enriquewph/PowerMike/docs/first-test-images/first-test (5).jpg

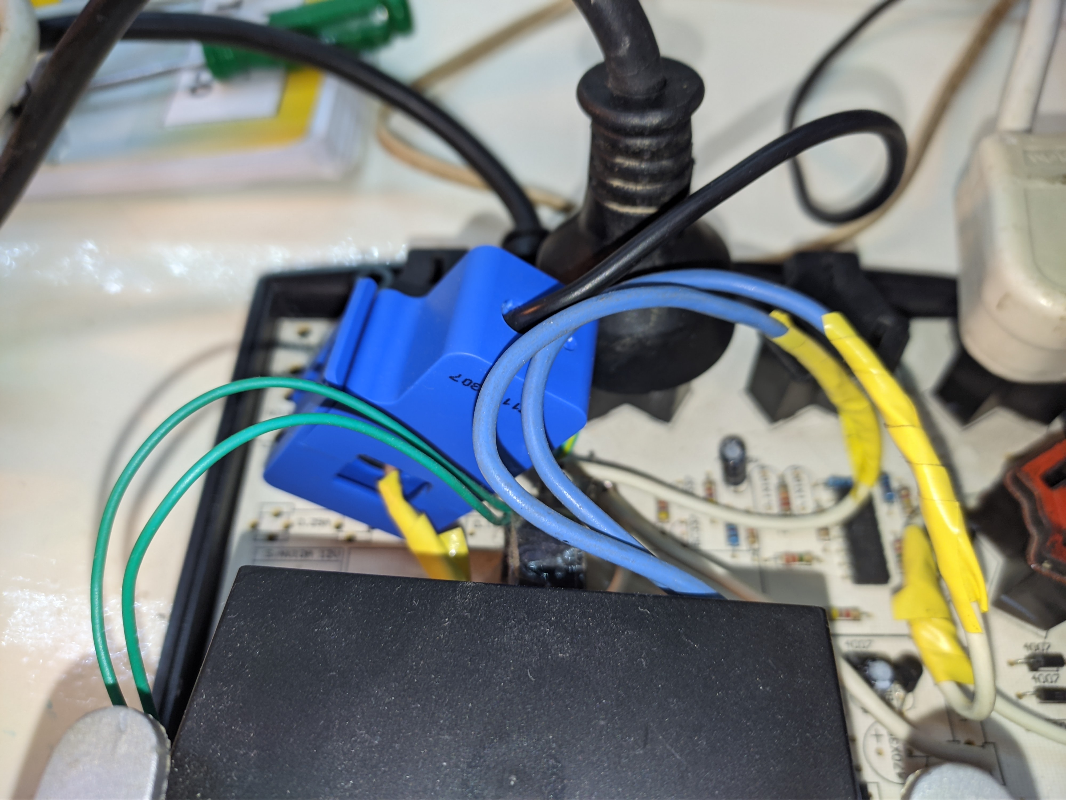
docs/first-test-images/first-test (5).jpg
