enriquewph/PowerMike/docs/first-test-images/first-test (2).jpg

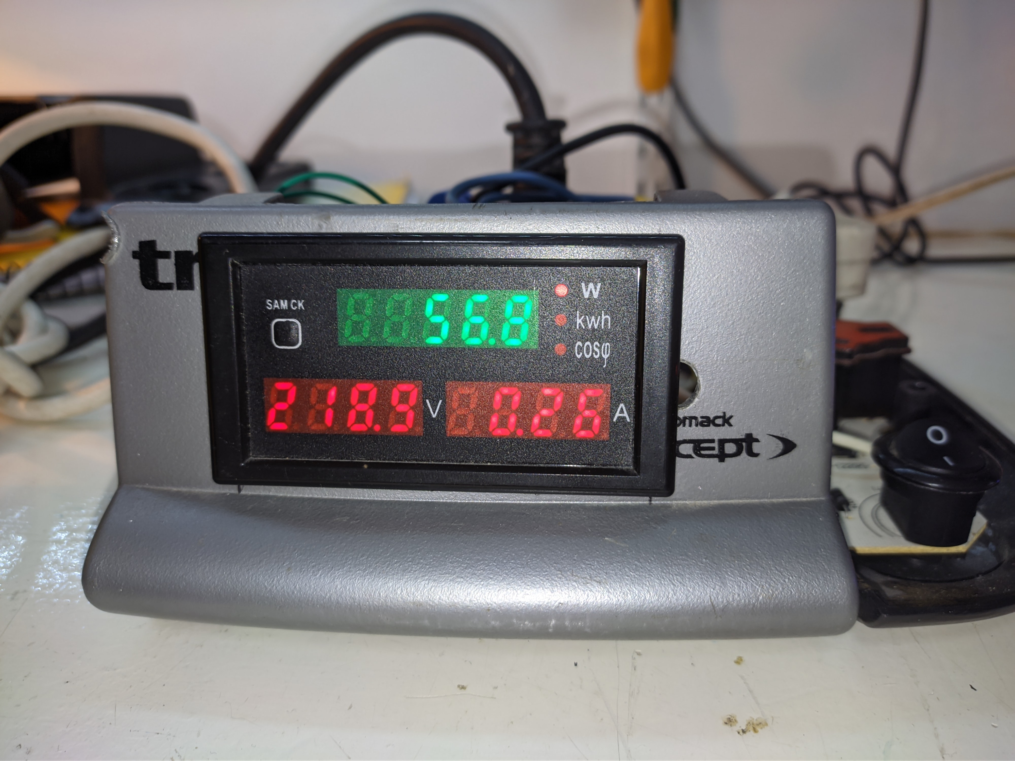
docs/first-test-images/first-test (2).jpg
