enriquewph/PowerMike/README.md

# PowerMike
Equipo para medir el consumo eléctrico de una vivienda.
