enriquewph/PowerMike/docs/qrlink.png

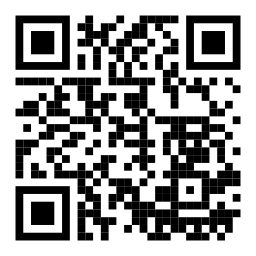
docs/qrlink.png
