enriquewph/PowerMike/hardware/export/conexionado.png

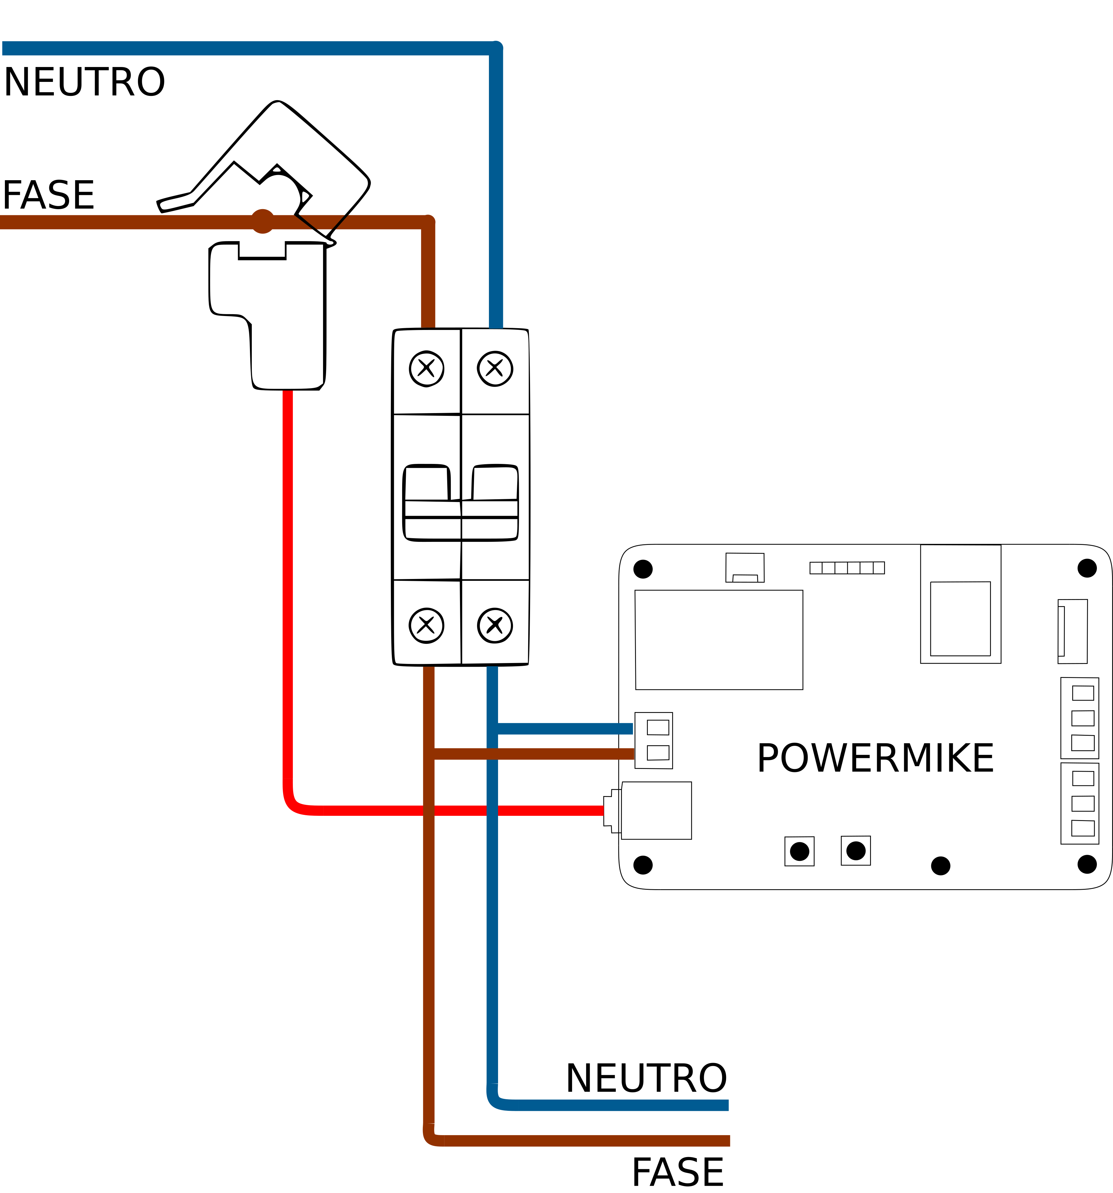
hardware/export/conexionado.png
