enriquewph/PowerMike/hardware/export/dwg.png

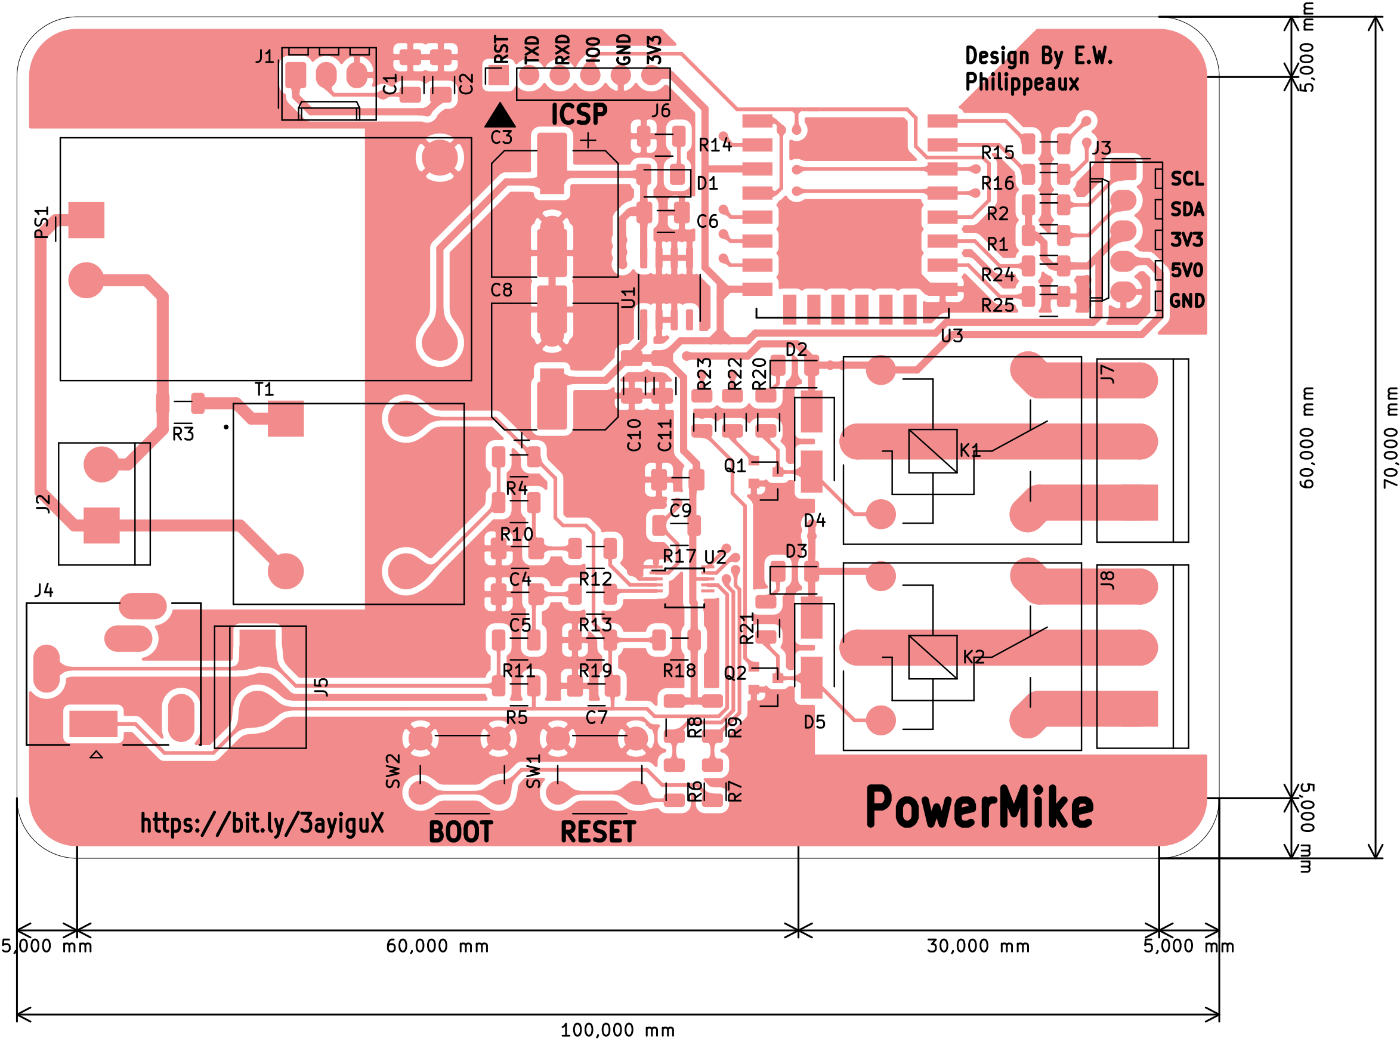
hardware/export/dwg.png
