enriquewph/PowerMike/hardware/export/pcb-solo-back.png

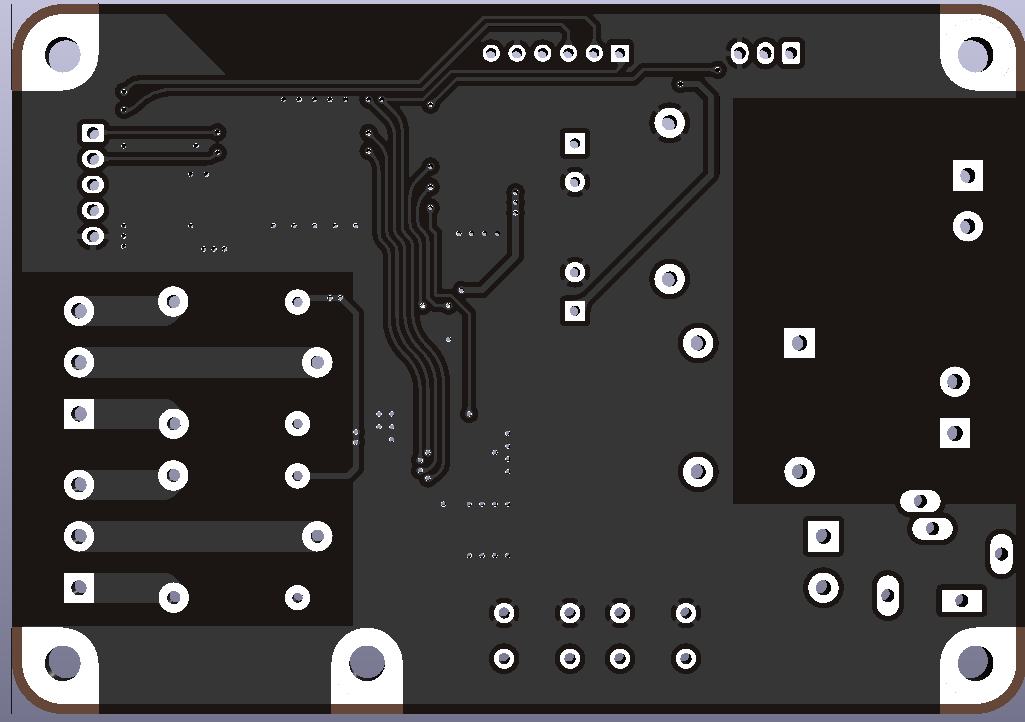
hardware/export/pcb-solo-back.png
