enriquewph/PowerMike/hardware/export/pcb-solo.png

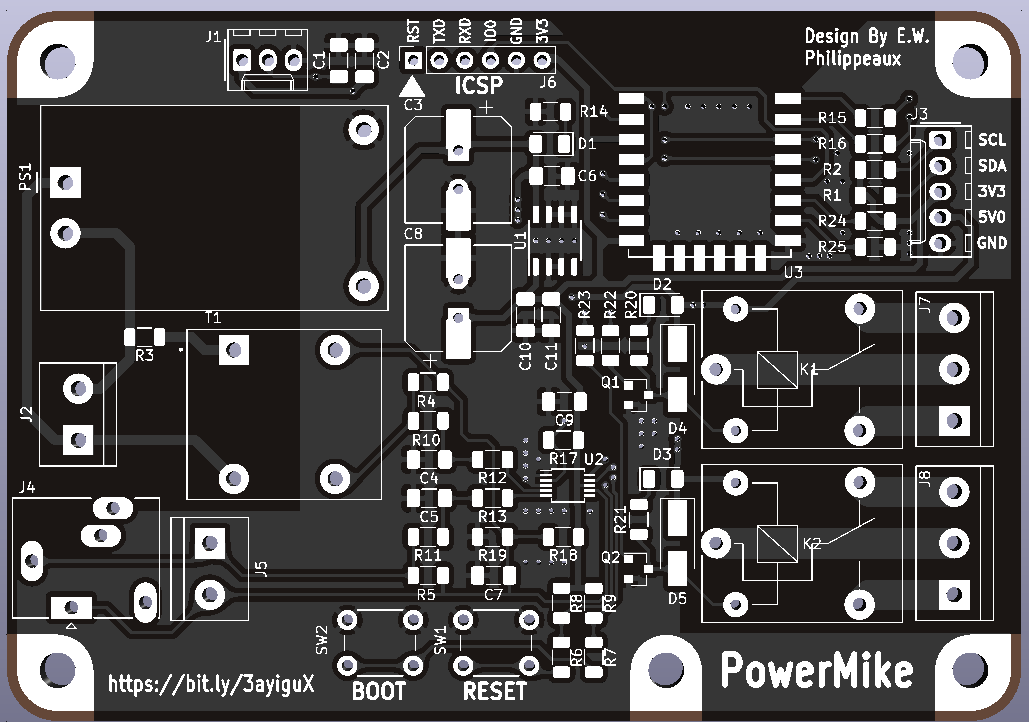
hardware/export/pcb-solo.png
