enriquewph/PowerMike/hardware/export/sch-descompuesto/alimentacion-sensores-adc.png

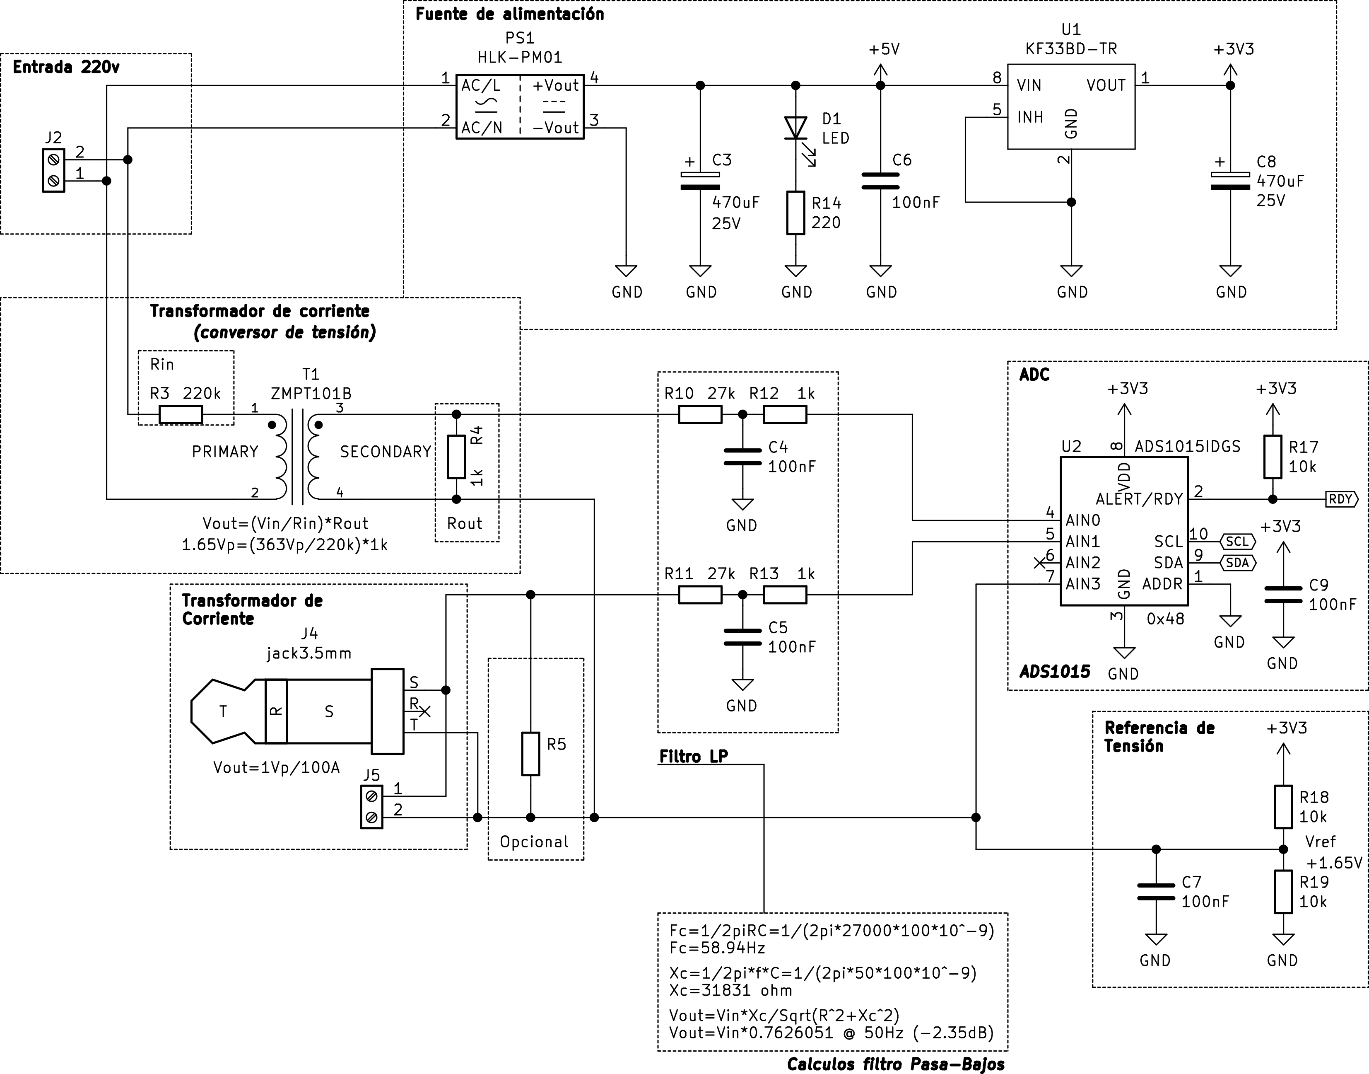
hardware/export/sch-descompuesto/alimentacion-sensores-adc.png
