enriquewph/PowerMike/hardware/export/sch-descompuesto/botones.png

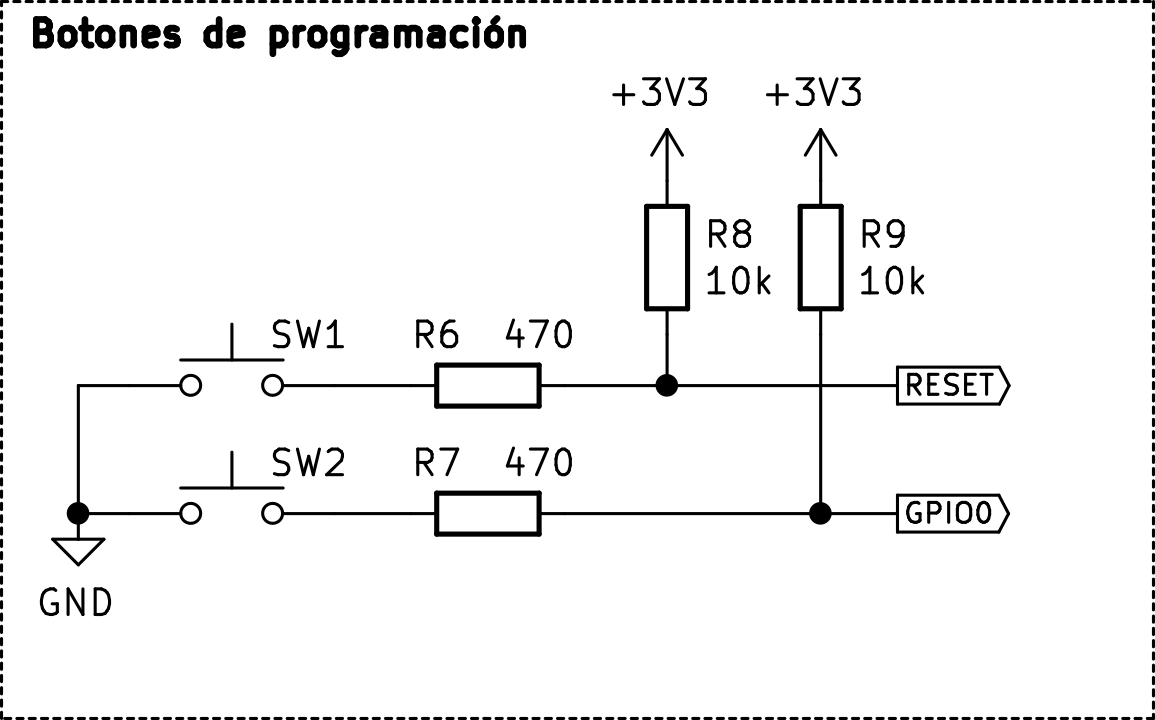
hardware/export/sch-descompuesto/botones.png
