enriquewph/PowerMike/hardware/export/sch-descompuesto/conectores.png

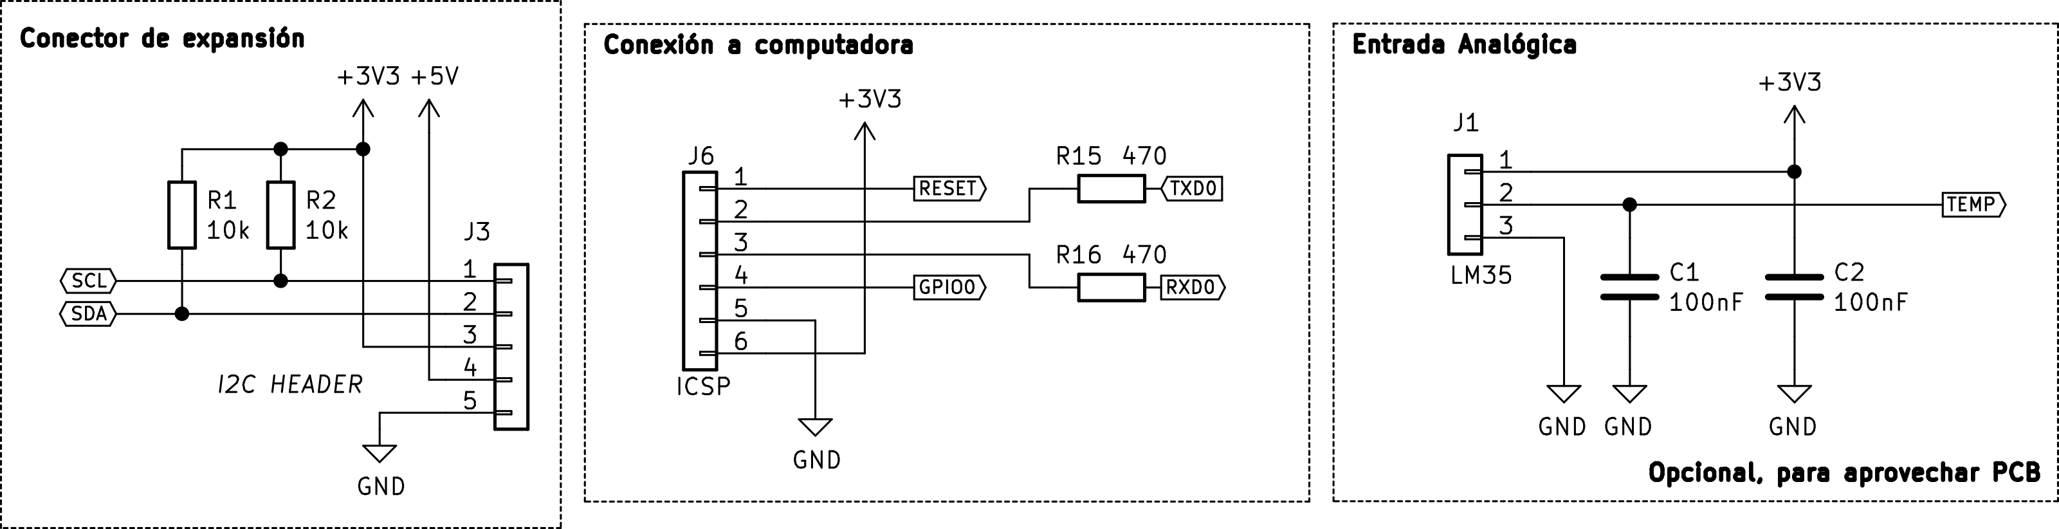
hardware/export/sch-descompuesto/conectores.png
