enriquewph/PowerMike/hardware/export/sch-descompuesto/microcontrolador.png

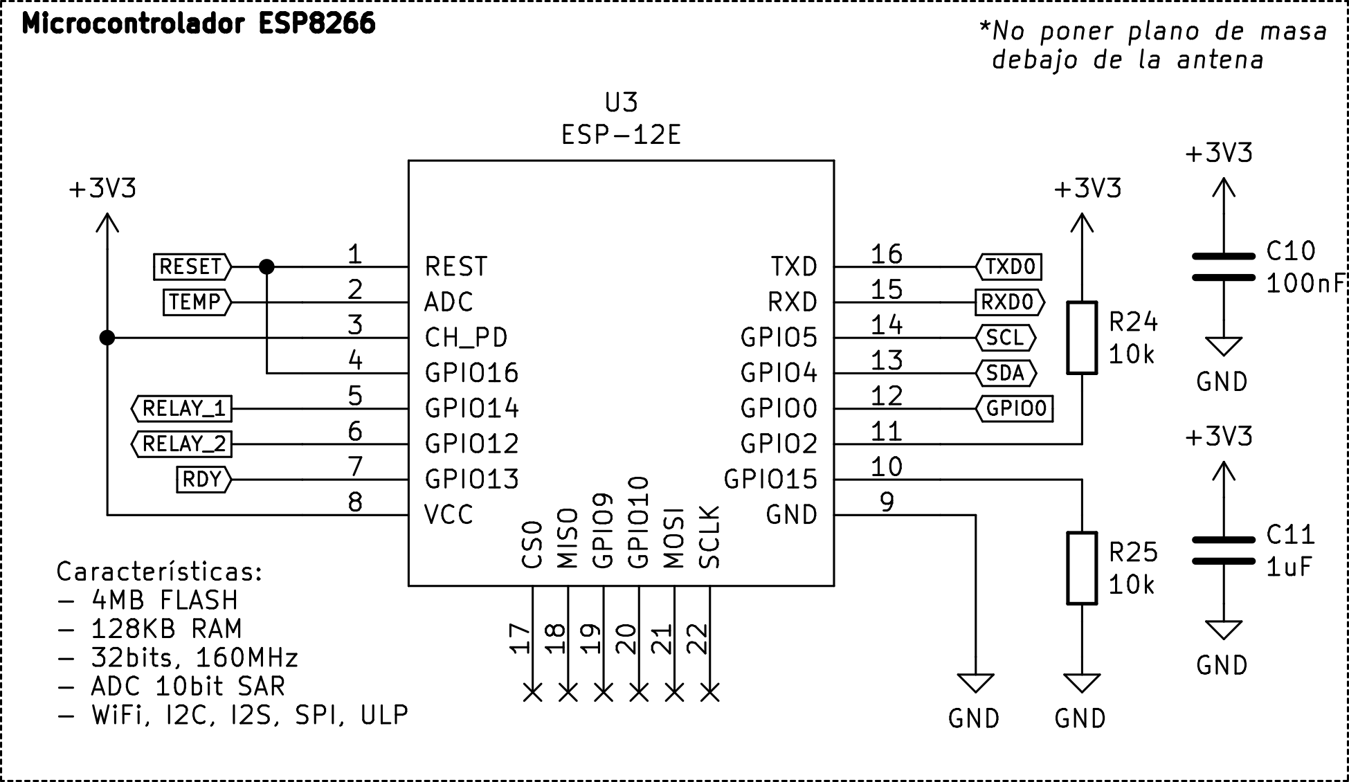
hardware/export/sch-descompuesto/microcontrolador.png
