enriquewph/PowerMike/hardware/export/sch-descompuesto/relays.png

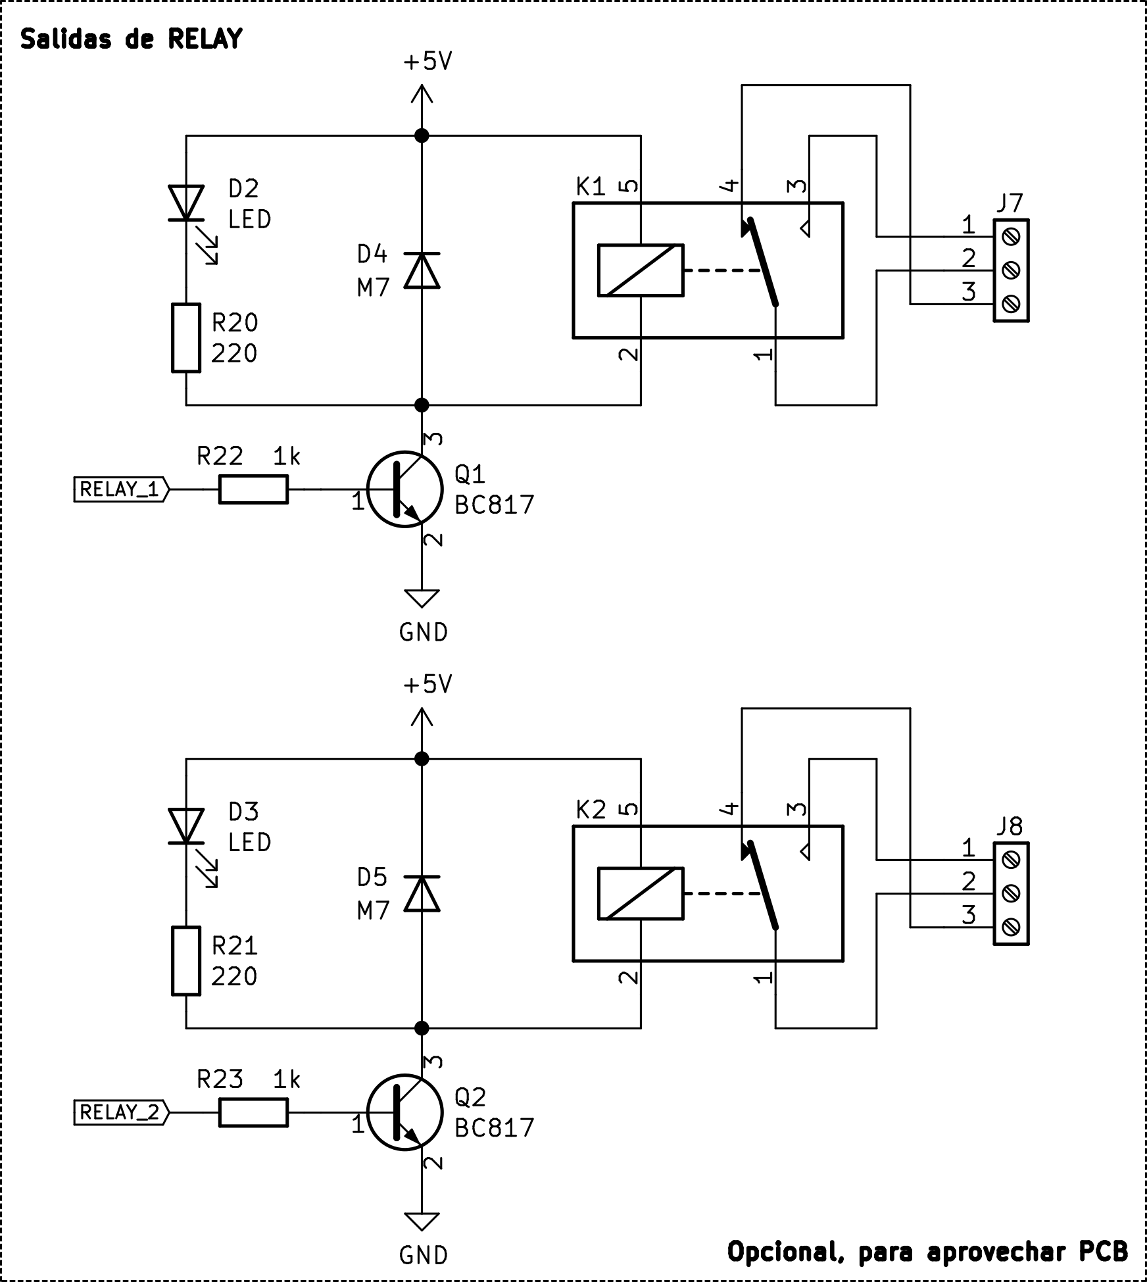
hardware/export/sch-descompuesto/relays.png
