enriquewph/PowerMike/hardware/export/sch.png

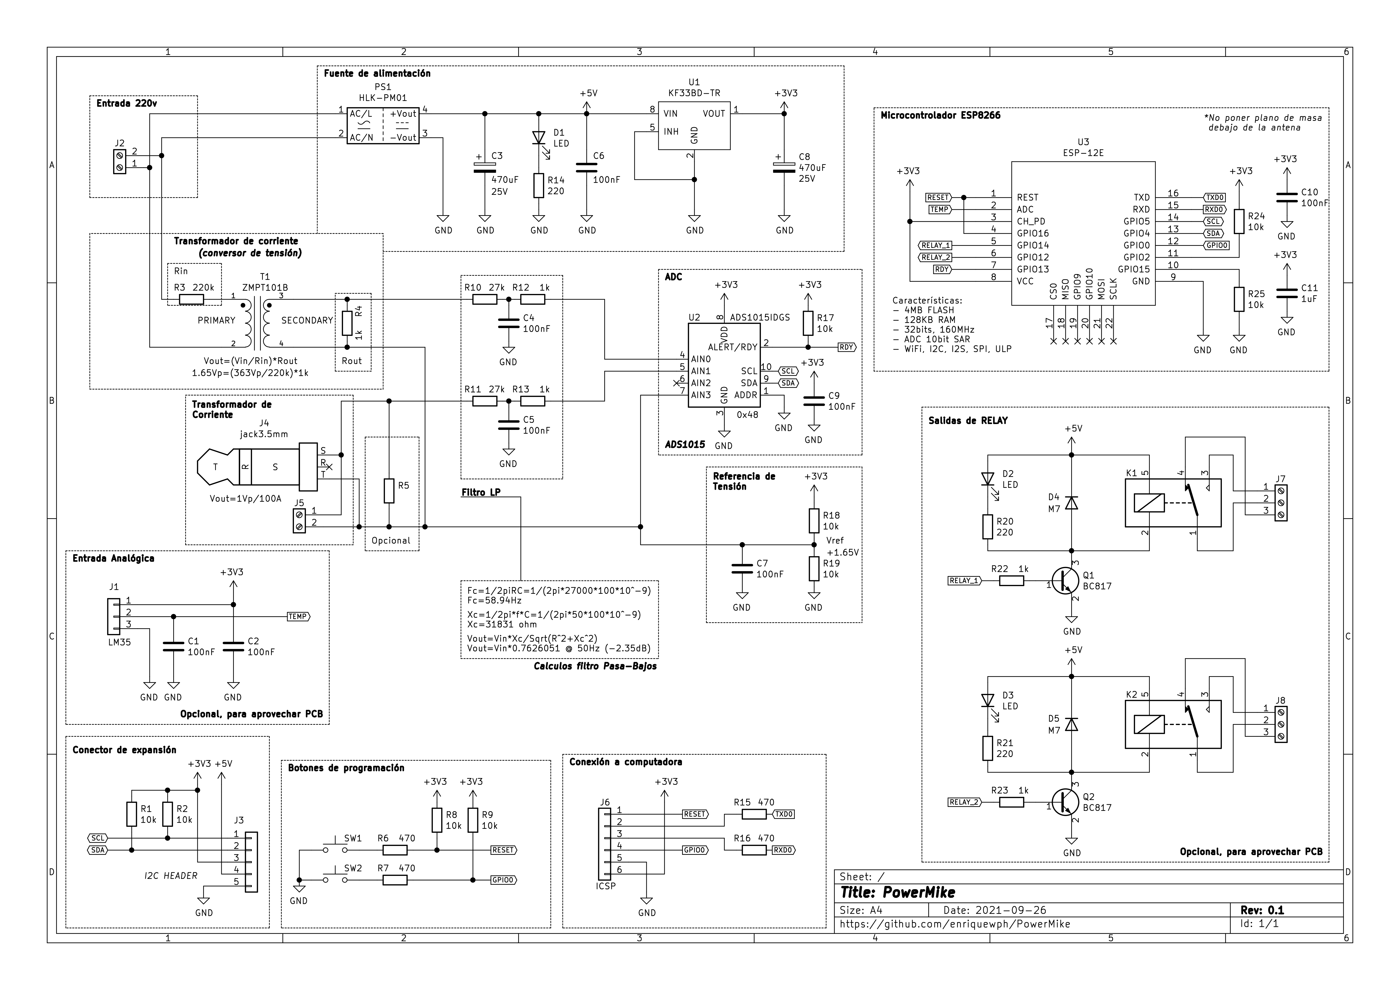
hardware/export/sch.png
