enriquewph/PowerMike/hardware/export/pcb-componentes.png

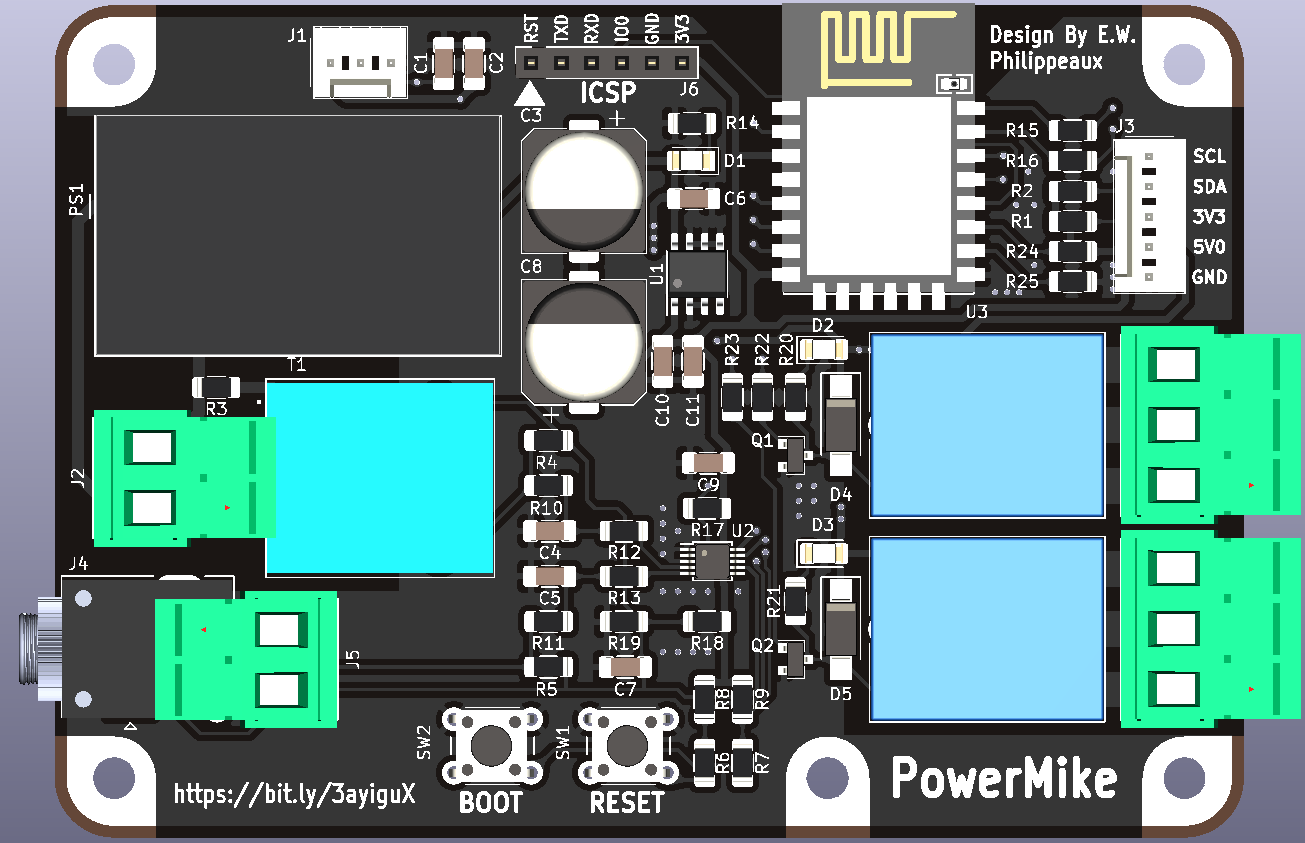
hardware/export/pcb-componentes.png
