enriquewph/PowerMike/hardware/3dcad/Ensamblaje1.SLDASM

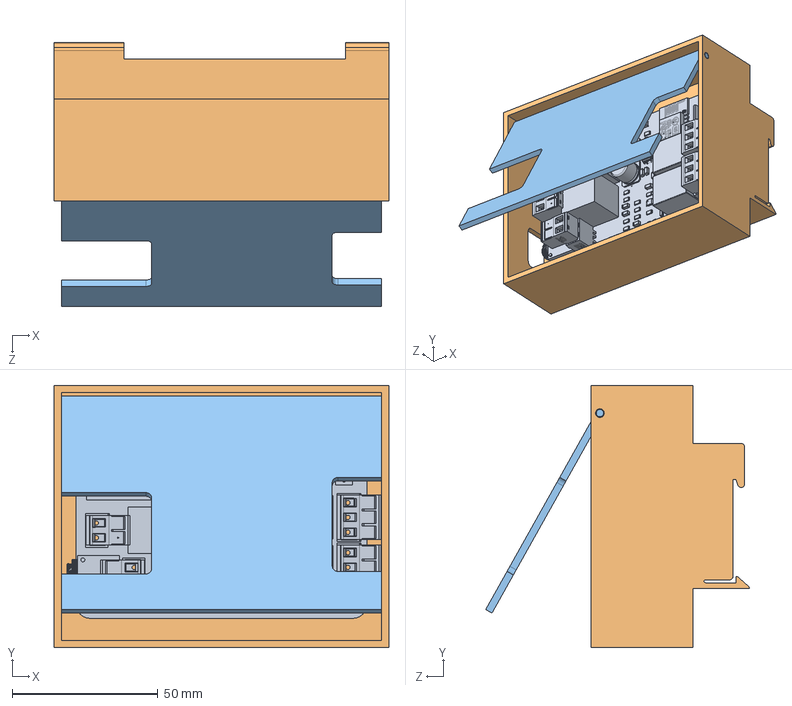
[picture p15: CAD file, 2022-03-10]
hardware/3dcad/Ensamblaje1.SLDASM
115.0 x 90.0 x 90.5 mm
powermike
caja
tapa
