enriquewph/PowerMike/hardware/3dcad/tapa.SLDPRT

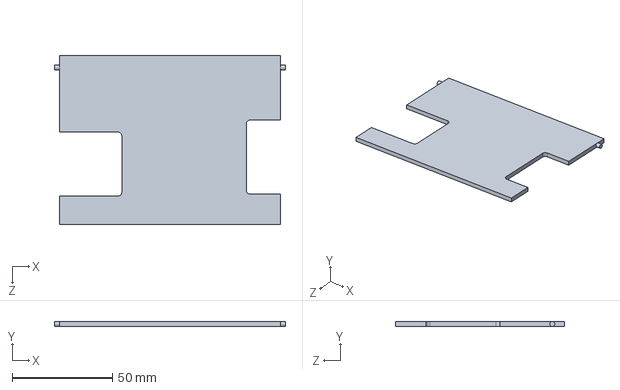
[picture p16: CAD file, 2022-03-10]
hardware/3dcad/tapa.SLDPRT
115.0 x 2.50 x 84.0 mm
