enriquewph/PowerMike/hardware/3dcad/caja.SLDPRT

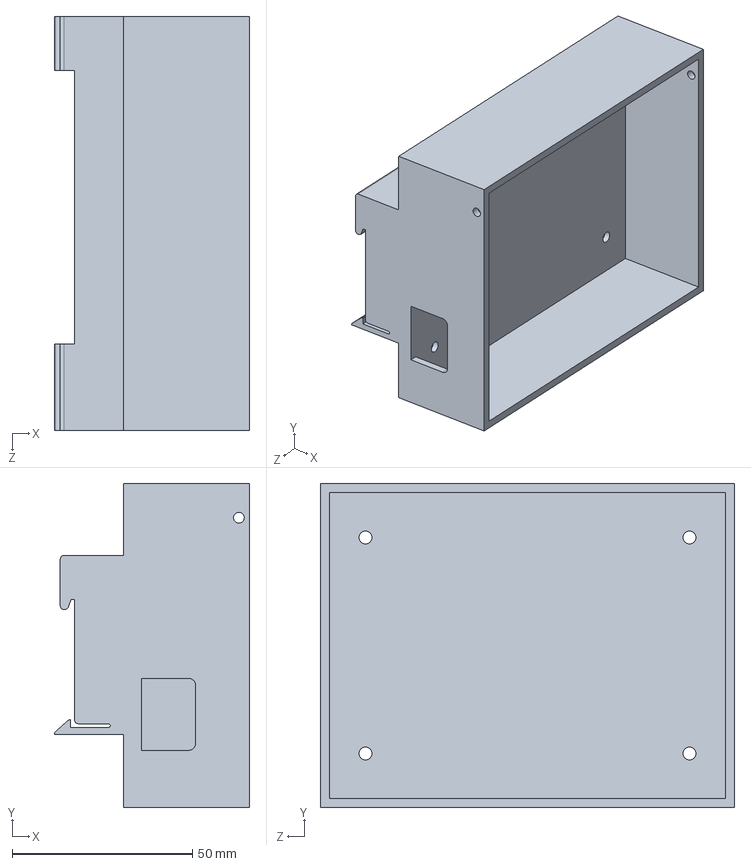
[picture p17: CAD file, 2022-03-10]
hardware/3dcad/caja.SLDPRT
54.3 x 90.0 x 115.0 mm
