enriquewph/PowerMike/docs/first-test-images/first-test (1).jpg

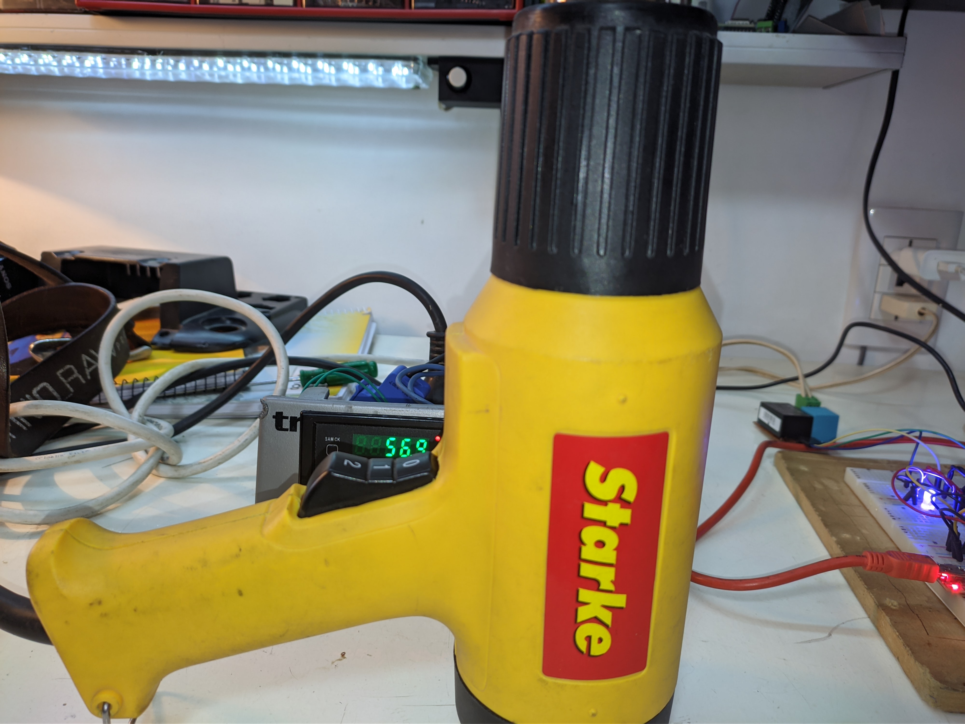
docs/first-test-images/first-test (1).jpg
