enriquewph/PowerMike/docs/first-test-images/first-test (3).jpg

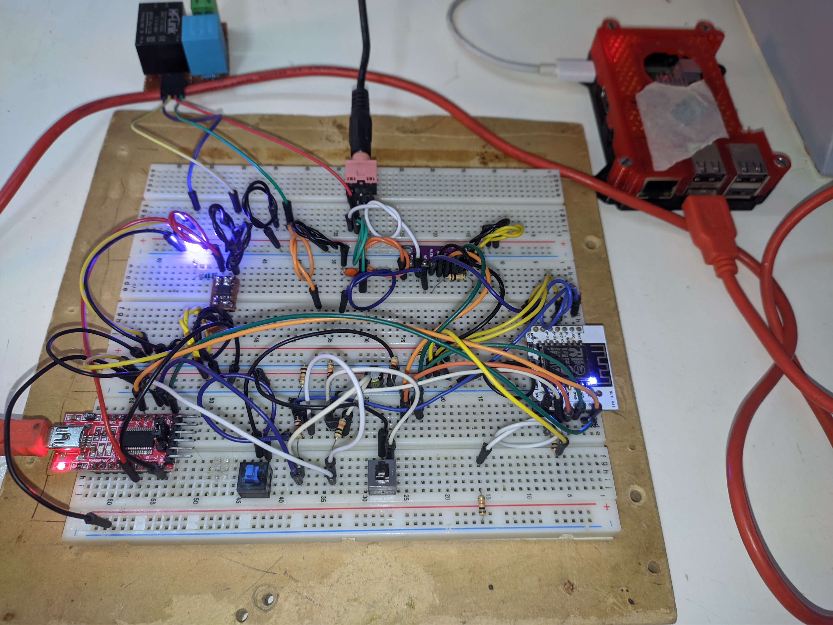
docs/first-test-images/first-test (3).jpg
