enriquewph/PowerMike/docs/first-test-images/first-test (4).jpg

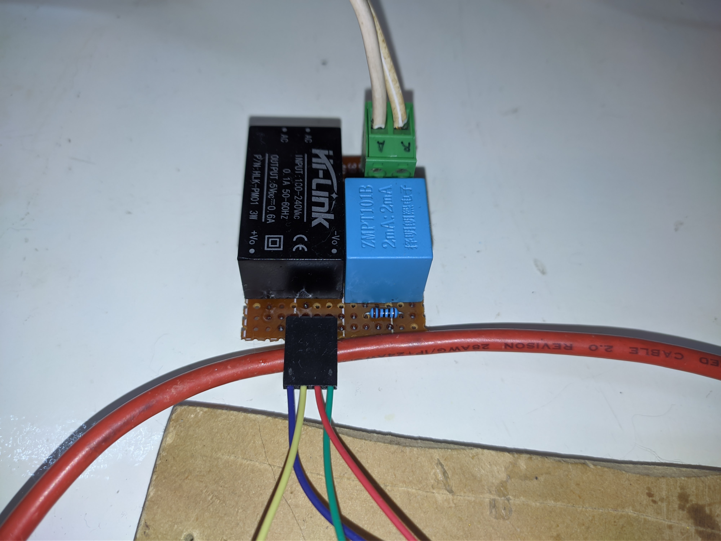
docs/first-test-images/first-test (4).jpg
