enriquewph/PowerMike/(threads)

Thread 1 (2021-09-22):

investigar como leer el sensor de corriente.

enriquewph, 2021-09-22:
usar ads1115 + sct-013-100

[guia en internet](https://www.poweruc.pl/blogs/news/non-invasive-sensor-yhdc-sct013-000-ct-used-with-arduino-sct-013)
[pdf ads1115](https://www.ti.com/lit/ds/symlink/ads1113.pdf?ts=1632242291830)

enriquewph, 2021-09-26:
https://github.com/pasko-zh/brzo_i2c

enriquewph, 2021-09-27:
viendo un toque como debemos medir, para hacer el calculo RMS necesitamos aprox 12 muestras por ciclo, para tener un error del 1%. Eso lo logramos con 50Hz * 12 -> 600 M/s.
El ADS1115 tiene un maximo de 860 M/s. pero eso seria usando un solo canal, usando 2, basicamente lo dividimos y quedarian aprox. 9 muestras por ciclo, lo cual nos aumenta mucho el error.

usemos 2, y si probando se puede con 1 genial. sino fue....

enriquewph, 2021-09-27:
para q no se acumule error, necesitamos que la cantidad de muestras por segundo sea un multiplo de 50. osea que el adc no nos serviria... podemos probar con el ADS1015 que es de 12 bits pero sirve hasta 3300 M/s

enriquewph, 2021-09-27:
3300 M/s nos da 66 muestras por ciclo. Si multiplexamos y usamos un canal para medir corriente y otro para tension, nos quedarian alrededor de 33 muestras por ciclo.

enriquewph, 2021-09-27:
la interrupcion que debemos manejar debe ejecutarse en menos de 0,3 milisegundos o rompemos el timing. Estaria muy jugado.
sino, usamos 2400M/s, y nos queda midiendo tension y corriente unas 24 mestras por ciclo, y el codigo de interrupcion puede durar hasta 0,41ms

lucasdavalle, 2021-09-30:
https://github.com/adafruit/Adafruit_ADS1X15 libreria de adafruit para arudino

lucasdavalle, 2021-10-01:
> viendo un toque como debemos medir, para hacer el calculo RMS necesitamos aproximadamente 12 muestras por ciclo, para tener un error del 1%. Eso lo logramos con 50Hz * 12 -> 600 M / s. El ADS1115 tiene un máximo de 860 M / s. pero eso seria usando un solo canal, usando 2, basicamente lo dividimos y quedarian aprox. 9 muestras por ciclo, lo cual nos aumenta mucho el error.
>
> usemos 2, y si probando se puede con 1 genial. sino fue ....

no entiendo por que no podriamos usar directamente 1 canal

lucasdavalle, 2021-10-01:
https://programarfacil.com/blog/arduino-blog/sct-013-consumo-electrico-arduino/

lucasdavalle, 2021-10-01:
https://www.youtube.com/watch?v=uRqT0gqZG6U

enriquewph, 2021-10-01:
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

1 canal para medir corriente
1 canal para medir tension

Thread 2 (2021-09-22):

diseñar filtros pasabajos

enriquewph, 2021-09-22:
como dice el titulo, con corte en 50Hz

JoacoSalguero, 2021-09-29:
http://www.learningaboutelectronics.com/Articulos/Calculadora-de-filtro-paso-bajo.php#respuesta1
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

enriquewph, 2021-09-29:
xd no hay R de 300 ohm que yo tenga, busquemos algo entre 0.1 y 1000nF

JoacoSalguero, 2021-10-02:
sisi me lo habias dicho por wsp y lo pasé antes.

JoacoSalguero, 2021-10-03:
Resistencias de cuanto tenes? Dame un rango

JoacoSalguero, 2021-10-03:
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

JoacoSalguero, 2021-10-03:
Pasé varias opciones, si hay problemas con R o C que no hay pasaje rangos y vuelvo a calcular

Closed 2021-10-06.

Thread 3 (2021-09-22):

Diseñar circuito de alimentación

enriquewph, 2021-09-22:
- [ ] Comprar un trafo 220v-6v y medirlo, por que vienen para atras aveces.
- [ ] Armar divisor resistivo para medirlo
- [ ] Armar una fuente switching para regular a 3.3v
- [ ] Filtrar la fuente switching

enriquewph, 2021-09-27:
para medir la tension podemos ir con el sig. circuito:
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

enriquewph, 2021-09-28:
Simular esto en proteus...

Closed 2021-10-07.

Thread 6 (2021-09-22):

Leer los sensores a huevo

enriquewph, 2021-09-22:
Obtener algun tipo de dato desde los sensores.
Implica, programar el codigo para leer el ADC Externo.

enriquewph, 2021-10-13:
Extendiendo un poco la prueba, conecte el sensor de corriente a una carga de alrededor de 1200 Watts.
Utilizando un sensor comercial de potencia, podemos determinar el error de nuestros resultados.
Los datos los extrajimos con un programa llamado SerialPlot
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

Las condiciones del ensayo se ven a continuación
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

y por ultimo, la hoja de excel con los datos que pudimos grabar.
[test3.xlsx](https://github.com/enriquewph/PowerMike/files/7334411/test3.xlsx)

Closed 2021-10-13.

Thread 7 (2021-09-22):

Procesar mediciones.

enriquewph, 2021-09-22:
necesitamos consumo en kw/h
para esto necesitamos medir watts
para esto necesitamos medir Corriente RMS    y   Voltaje RMS
Irms * Vrms = Wrms
Integrando Wrms en el tiempo tenemos W/hora

Thread 9 (2021-09-22):

Programa en linux

enriquewph, 2021-09-22:
- [ ] Leer los datos del ESP
- [ ] Guardar los datos
- [ ] Mostrar un grafico al usuario (De consumo)

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

opciones de visualizacion:
- Ultimas 24 horas
- Ultimos 7 dias
- Ultimo Mes
- X mes.
- Ultimo Año
- X año.
