enriquewph/PowerMike/hardware/export/sch.pdf

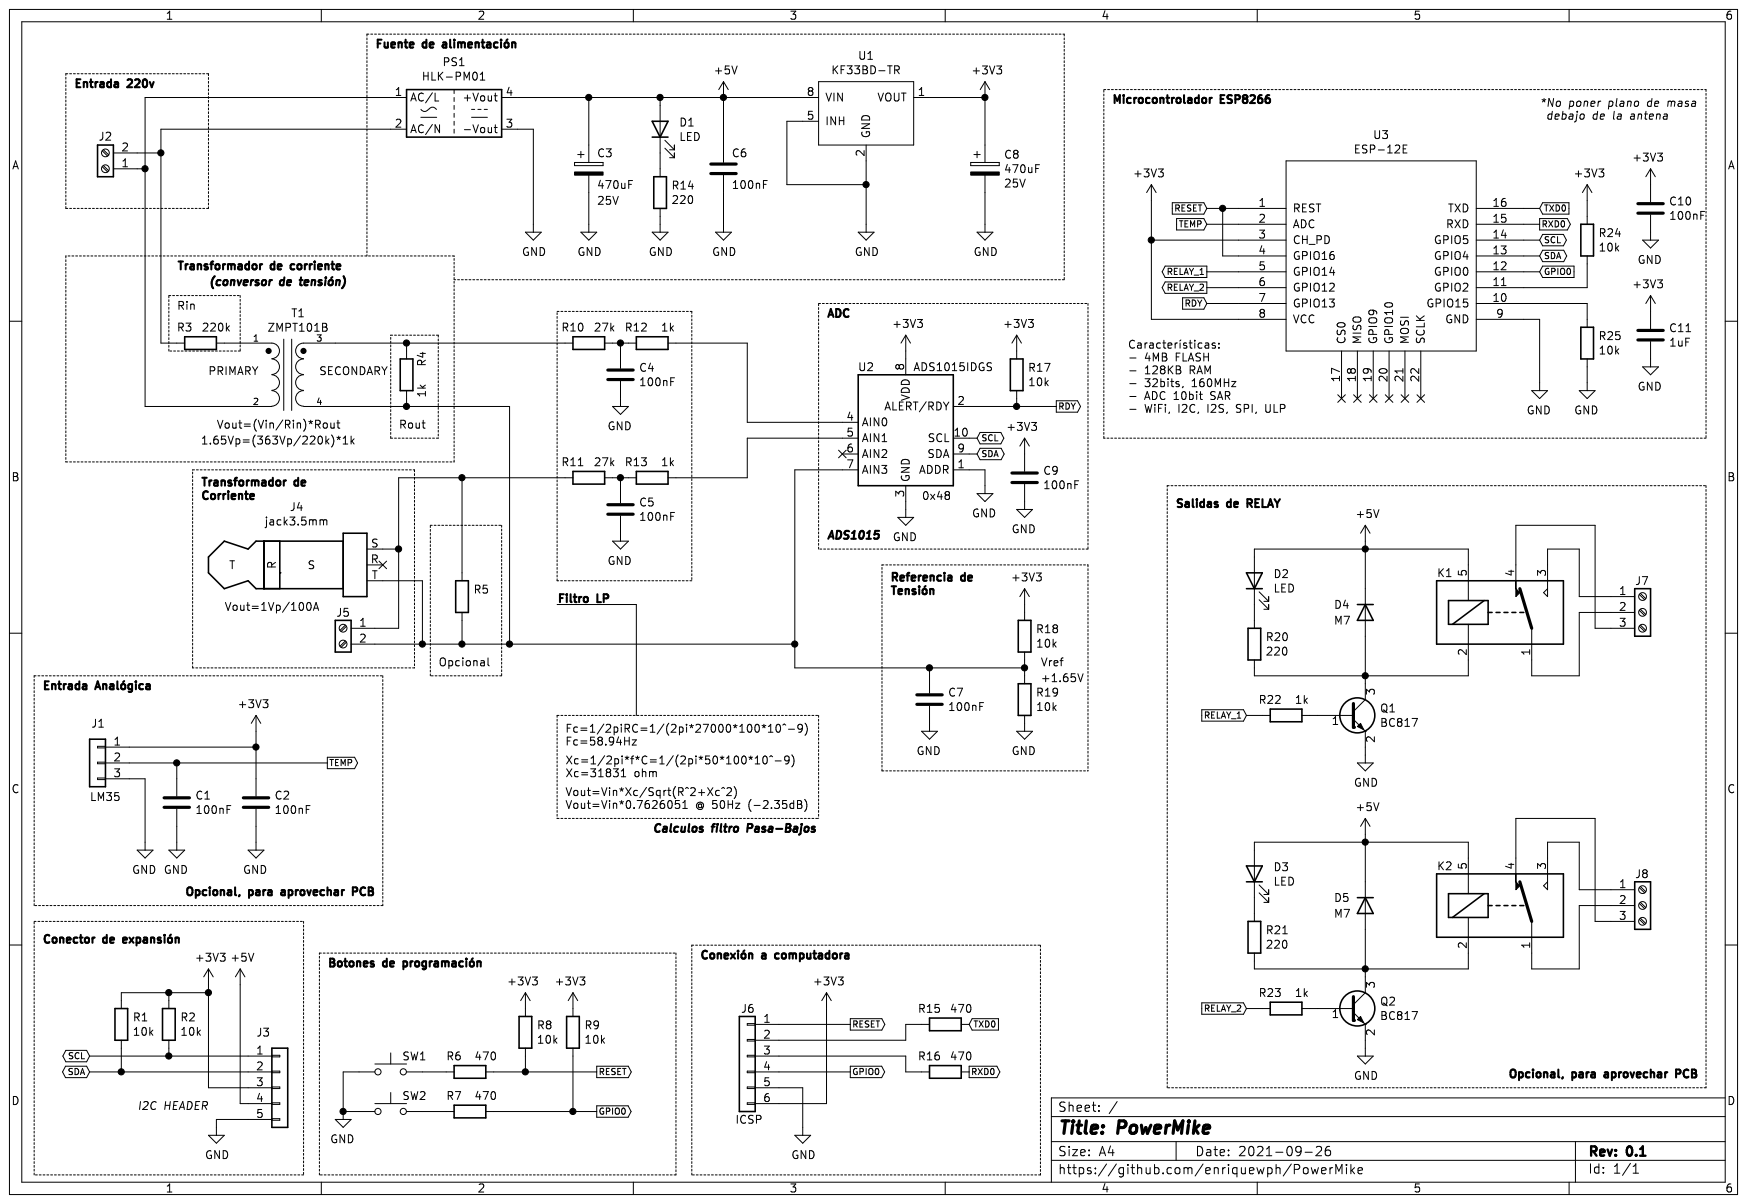
[picture p21: page 1]
