enriquewph/PowerMike/hardware/kicad.kicad_pcb

## KiCad design hardware/kicad.kicad_pcb (2022-03-10)

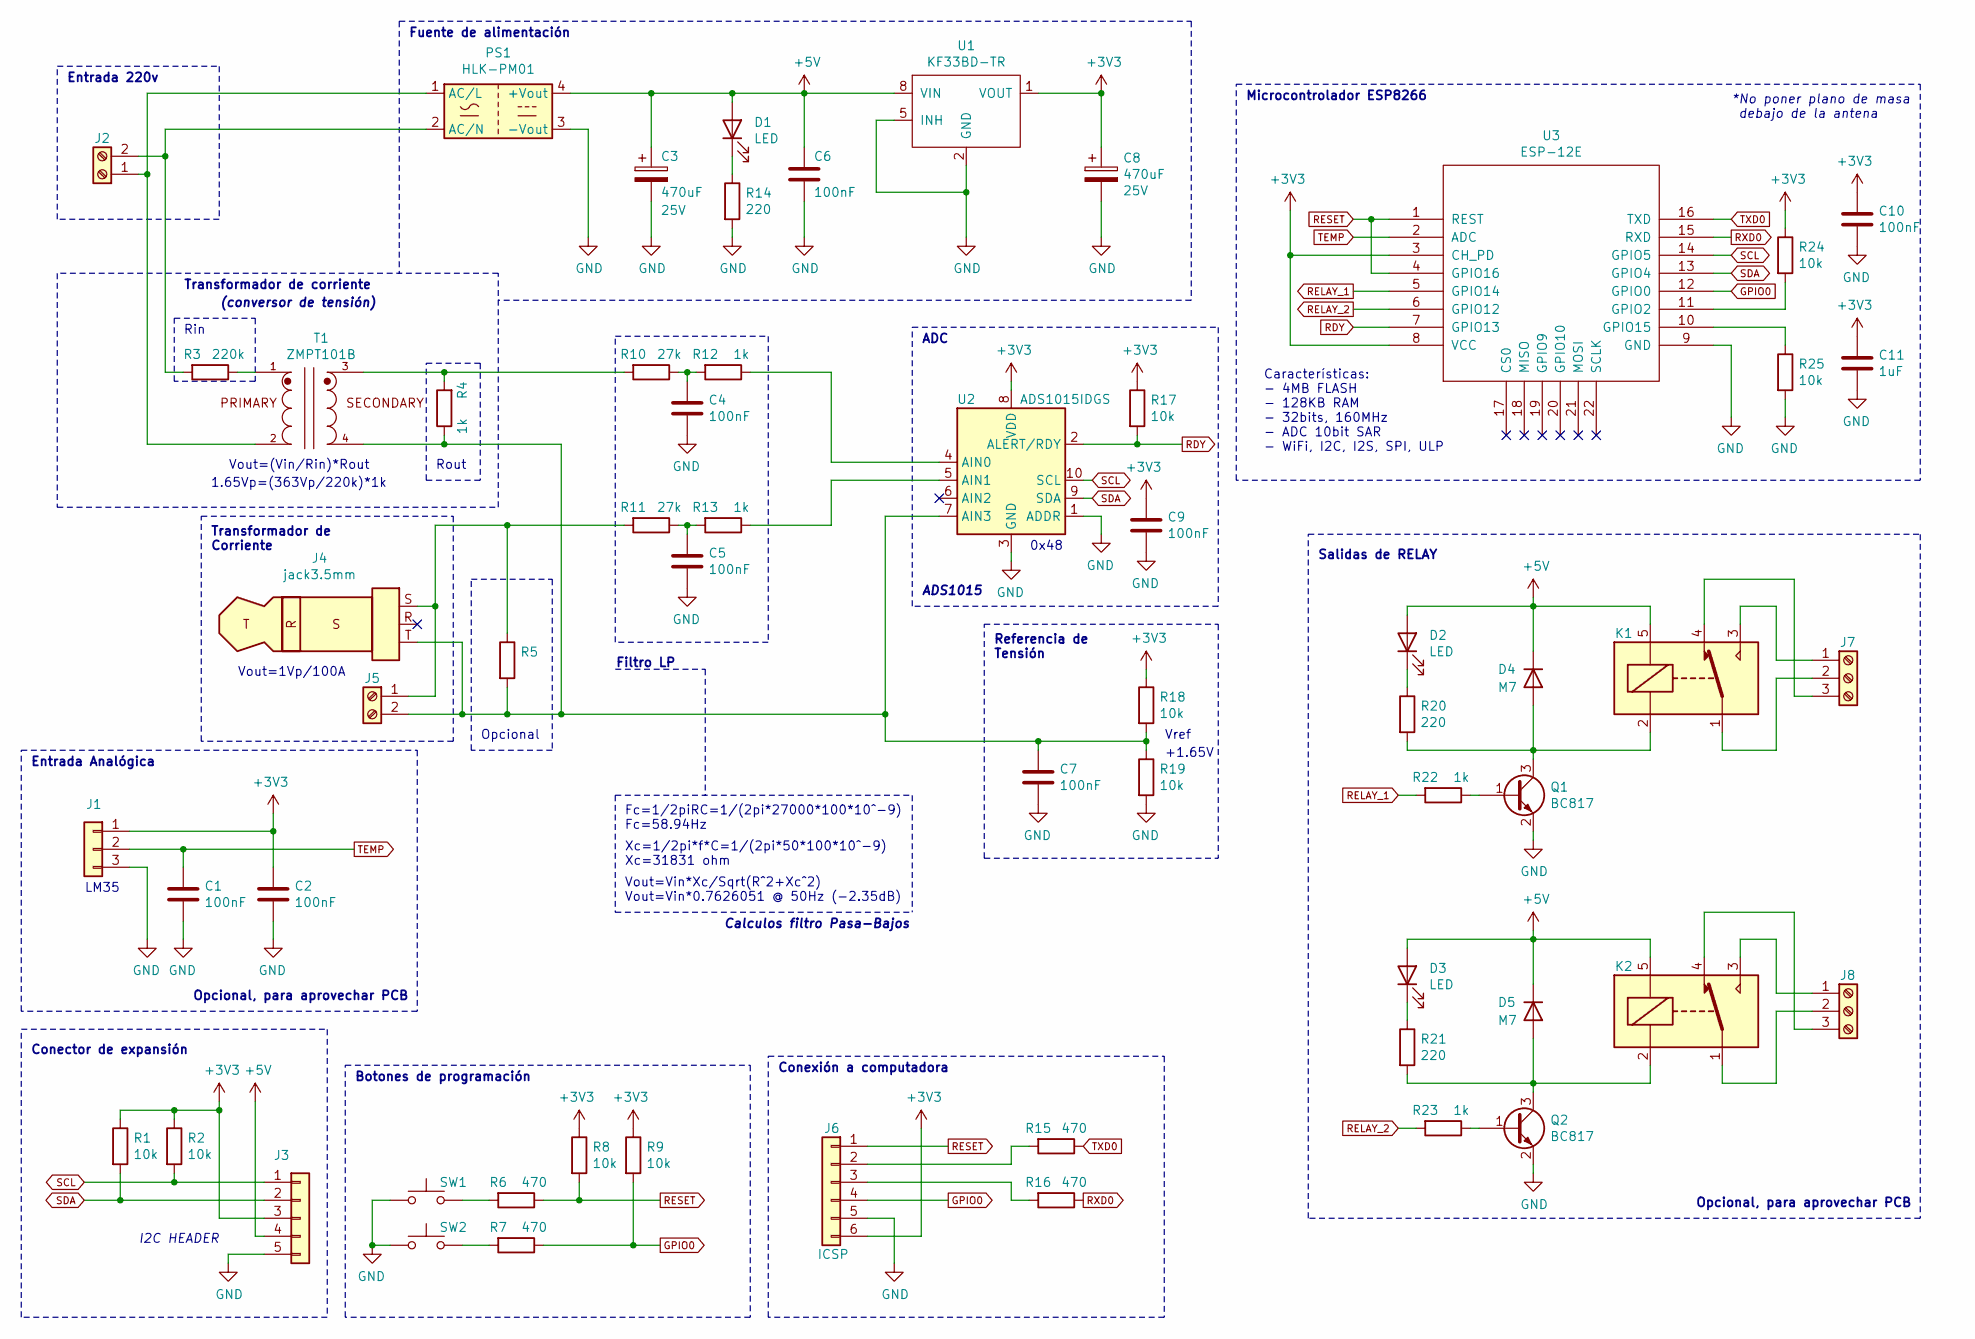
[picture p22: schematic kicad.sch, PowerMike]

Parts:
C1, C2, C4, C5, C6, C7, C9, C10: 100nF; C_1206_3216Metric_Pad1.33x1.80mm_HandSolder; Voltage 50V
C3, C8: 470uF; CAP_10x10_SMD_THT; Voltage 25V
C11: 1uF; C_1206_3216Metric_Pad1.33x1.80mm_HandSolder; Voltage 50V
D1, D2, D3: LED; LED_1206_3216Metric
D4, D5: M7; D_SMA_Handsoldering
J1: Conn_01x03; Molex_KK-254_AE-6410-03A_1x03_P2.54mm_Vertical
J2, J5: Screw_Terminal_01x02; TerminalBlock_bornier-2_P5.08mm
J3: Conn_01x05; Molex_KK-254_AE-6410-05A_1x05_P2.54mm_Vertical
J4: jack3.5mm; Jack_3.5mm_Ledino_KB3SPRS_Horizontal
J6: ICSP; PinSocket_1x06_P2.54mm_Vertical
J7, J8: Screw_Terminal_01x03; TerminalBlock_bornier-3_P5.08mm
K1, K2: RELAY 0510; Relay_SPDT_SANYOU_SRD_Series_Form_C
PS1: HLK-PM01; Converter_ACDC_HiLink_HLK-PMxx
Q1, Q2: BC817; SOT-23
R1, R2, R8, R9, R17, R18, R19, R24, R25: 10k; R_1206_3216Metric
R3: 220k; R_1206_3216Metric
R4, R12, R13, R22, R23: 1k; R_1206_3216Metric
R5: ?; R_1206_3216Metric
R6, R7, R15, R16: 470; R_1206_3216Metric
R10, R11: 27k; R_1206_3216Metric
R14, R20, R21: 220; R_1206_3216Metric
SW1, SW2: SW_Push; SW_PUSH_6mm
T1: ZMPT101B
U1: KF33BD-TR; SO-8_3.9x4.9mm_P1.27mm
U2: ADS1015IDGS; TSSOP-10_3x3mm_P0.5mm
U3: ESP-12E; ESP-12E_SMD

Connections:
+3V3: C2.1, C8.1, C9.1, C10.1, C11.1, J1.1, J3.3, J6.6, R1.1, R2.1, R8.1, R9.1, R17.1, R18.1, R24.1, U1.1 (VOUT), U2.8 (VDD), U3.3 (CH_PD), U3.8 (VCC)
+5V: C3.1, C6.1, D1.2 (A), D2.2 (A), D3.2 (A), D4.1 (K), D5.1 (K), J3.4, K1.5, K2.5, PS1.4 (+Vout), U1.8 (VIN)
GND: C1.2, C2.2, C3.2, C4.2, C5.2, C6.2, C7.2, C8.2, C9.2, C10.2, C11.2, J1.3, J3.5, J6.5, PS1.3 (-Vout), Q1.2 (E), Q2.2 (E), R14.2, R19.2, R25.2, SW1.1, SW2.1, U1.2 (GND), U1.3 (GND), U1.5 (INH), U1.6 (GND), U1.7 (GND), U2.1 (ADDR), U2.3 (GND), U3.9 (GND)
GPIO0: J6.4, R7.1, R9.2, U3.12 (GPIO0)
unnamed: C4.1, R10.1, R12.2
unnamed: C5.1, R11.1, R13.2
unnamed: C7.1, J4.T, J5.2, R4.1, R5.2, R18.2, R19.1, T1.4, U2.7 (AIN3)
unnamed: D1.1 (K), R14.1
unnamed: D2.1 (K), R20.1
unnamed: D3.1 (K), R21.1
unnamed: D4.2 (A), K1.2, Q1.3 (C), R20.2
unnamed: D5.2 (A), K2.2, Q2.3 (C), R21.2
unnamed: J2.1, PS1.1 (AC/L), T1.2
unnamed: J2.2, PS1.2 (AC/N), R3.2
unnamed: J4.S, J5.1, R5.1, R11.2
unnamed: J6.2, R15.2
unnamed: J6.3, R16.2
unnamed: J7.1, K1.3
unnamed: J7.2, K1.1
unnamed: J7.3, K1.4
unnamed: J8.1, K2.3
unnamed: J8.2, K2.1
unnamed: J8.3, K2.4
unnamed: Q1.1 (B), R22.1
unnamed: Q2.1 (B), R23.1
unnamed: R3.1, T1.1
unnamed: R6.2, SW1.2
unnamed: R7.2, SW2.2
unnamed: R4.2, R10.2, T1.3
unnamed: R12.1, U2.4 (AIN0)
unnamed: R13.1, U2.5 (AIN1)
unnamed: R24.2, U3.11 (GPIO2)
unnamed: R25.1, U3.10 (GPIO15)
RDY: R17.2, U2.2 (ALERT/RDY), U3.7 (GPIO13)
RELAY_1: R22.2, U3.5 (GPIO14)
RELAY_2: R23.2, U3.6 (GPIO12)
RESET: J6.1, R6.1, R8.2, U3.1 (REST), U3.4 (GPIO16)
RXD0: R16.1, U3.15 (RXD)
SCL: J3.1, R2.2, U2.10 (SCL), U3.14 (GPIO5)
SDA: J3.2, R1.2, U2.9 (SDA), U3.13 (GPIO4)
TEMP: C1.1, J1.2, U3.2 (ADC)
TXD0: R15.1, U3.16 (TXD)

Notes on the sheet:
LM35
I2C HEADER
0x48
Opcional
Vout=(Vin/Rin)*Rout
Rin
Rout
1.65Vp=(363Vp/220k)*1k
Vref
+1.65V
Opcional, para aprovechar PCB
Conexión a computadora
Botones de programación
Conector de expansión
Vout=1Vp/100A
Filtro LP
Fc=1/2piRC=1/(2pi*27000*100*10^-9) Fc=58.94Hz
Xc=1/2pi*f*C=1/(2pi*50*100*10^-9) Xc=31831 ohm
Vout=Vin*Xc/Sqrt(R^2+Xc^2) Vout=Vin*0.7626051 @ 50Hz (-2.35dB)
Calculos filtro Pasa-Bajos
Microcontrolador ESP8266
Características: - 4MB FLASH - 128KB RAM - 32bits, 160MHz - ADC 10bit SAR - WiFi, I2C, I2S, SPI, ULP
Entrada 220v
Fuente de alimentación
ADC
Referencia de Tensión
Transformador de Corriente
Transformador de corriente
(conversor de tensión)
ADS1015
*No poner plano de masa debajo de la antena
Salidas de RELAY
Entrada Analógica

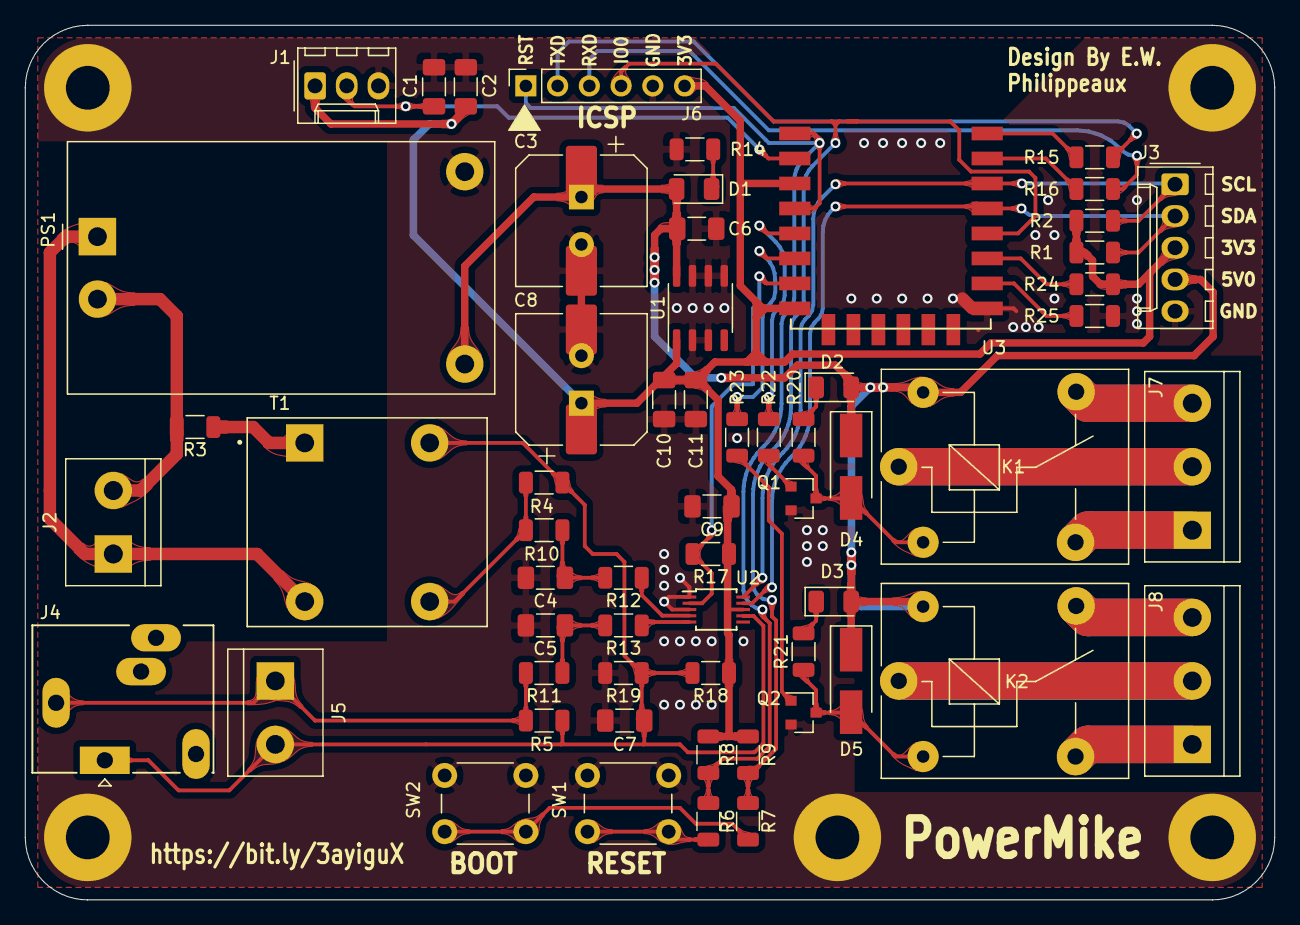
[picture p23: board kicad.kicad_pcb from above]

Board: 2 copper layers, 100.0 x 70.0 mm, 60 parts (0 on the bottom side), 42 nets.
