enriquewph/PowerMike/(commit log)

2022-03-10 Reorganizacion del repo
    [Ensamblaje1.SLDASM, caja.SLDPRT, kicad.kicad_pcb, kicad.sch, tapa.SLDPRT]
2022-03-10 Usar smartconfig para setup wifi
2022-03-11 grandes avances en la conectividad
